rabbits-robotics/gamma_turret_pcb/docs/回路図作成リファレンス.md

# ESP32-P4キャリア 回路リファレンス（現状版）

2026-08-10全面改訂: **完成した回路図のネットリストから機械生成**した現状正引き文書。
初版（描き始め用ガイド。逆接保護・TVS・ESC保護抵抗・PWR_FLAG等の不採用部品を含む）はgit履歴を参照。
設計判断の経緯・理由は `2026-08-10-esp32-p4-carrier-design.md`。

## 1. U1（Stampソケット）ピン対応

| ピン# | Stamp信号 | 接続先 | | ピン# | Stamp信号 | 接続先 |
|---|---|---|---|---|---|---|
| 1 | G15 | IMU_RX ← U3.3(BNO055のT) | | 11 | G23 | CAN1_TX → U6.1（D4アクティビティLED付き） |
| 2 | G12 | IMU_TX → U3.4（R7 10kプルアップ） | | 12 | G21 | CAN1_RX ← U6.4 |
| 3 | G10 | SRV_RX（R1 1k経由で合流点へ） | | 13 | G19 | CAN2_TX → U5.1（D5 LED付き） |
| 4 | G8 | SRV_TX（R2 1k経由で合流点へ・D6 LED付き） | | 14 | G17 | CAN2_RX ← U5.4 |
| 5 | G1 | FIRE_LEFT_MOTOR → FireLeft1.1 | | 15 | 3V3出力 | +3V3レール |
| 6 | G0 | FIRE_RIGHT_MOTOR → FireRight1.1 | | 16 | G37⚠ | R17 10kプルアップ＋D2デバッグLED（吸い込み） |
| 7 | GND | GND | | 17 | G38⚠ | R18 10kプルアップ＋D3デバッグLED（吸い込み） |
| 8 | VBUS | +5V（M78AR05出力） | | 18 | EN | RESET_SW1 → GND |
| 9 | G27 | PC_RX ← R6(220) ← PC1.2 | | 19 | G35⚠ | BOOT_SW1 → GND |
| 10 | G26 | PC_TX → R5(220) → PC1.1（R4 10kプルアップはコネクタ側） | | 20 | GND | GND |

⚠=ブートストラップピン（G37/G38はLED・プルアップのみ＝出力系で安全運用、G35はボタン専用）

## 2. 部品一覧（回路図の実体・全46点）

| Ref | 値 | 役割 |
|---|---|---|
| 24Vin1 | Conn_01x02 | XT30オス 24V入力 |
| BOOT_SW1 | SW_Push | タクトSW 低背4.3mm（BOOT） |
| C1 | 100n | 100n U6パスコン |
| C2 | 100n | 100n U5パスコン |
| C3 | 100u | 100µ電解 +5V出力側 |
| C4 | 100u | 100µ電解 +24V入力 |
| C5 | 22u | 22µ積セラ +24V入力 |
| CAN1 | Conn_01x02 | PH2P CANH/L |
| CAN2 | Conn_01x02 | PH2P CANH/L |
| D1 | LED | LED緑 電源+5V |
| D2 | LED | LED黄 デバッグG37 |
| D3 | LED | LED黄緑 デバッグG38 |
| D4 | LED | LED赤 CAN1アクティビティ |
| D5 | LED | LED赤 CAN2アクティビティ |
| D6 | LED | LED橙 サーボアクティビティ |
| DCDCin | Conn_01x02 | XT30オス 7.4V入力（外部DCDCから） |
| DCDCout | Conn_01x02 | XT30メス 24V出力（外部DCDCへ） |
| FireLeft1 | Conn_01x02 | PH2P ESC信号左 |
| FirePower1 | Conn_01x02 | XH2P 7.5V分配 |
| FirePower2 | Conn_01x02 | XH2P 7.5V分配 |
| FireRight1 | Conn_01x02 | PH2P ESC信号右 |
| PC1 | Conn_01x03 | PH3P Jetson UART |
| R1 | 1k | 1k サーボ合流RX側 |
| R10 | 1k | 1k LED D2 |
| R11 | 1k | 1k LED D3 |
| R12 | 1k | 1k LED D4 |
| R13 | 1k | 1k LED D5 |
| R14 | 1k | 1k LED D6 |
| R17 | 10k | 10k G37プルアップ |
| R18 | 10k | 10k G38プルアップ |
| R19 | 120 | 120 CAN1終端 |
| R2 | 1k | 1k サーボ合流TX側 |
| R3 | 10k | 10k サーボバスプルアップ |
| R4 | 10k | 10k Jetson TXプルアップ |
| R5 | 220 | 220 Jetson TX直列 |
| R6 | 220 | 220 Jetson RX直列 |
| R7 | 10k | 10k IMU_TXプルアップ |
| R8 | 1k | 1k 電源LED |
| R9 | 120 | 120 CAN2終端 |
| RESET_SW1 | SW_Push | タクトSW 7mm（RESET） |
| SRV1 | Conn_01x03 | XH3P ST3215バス |
| U1 | M5Stack_Stamp-P4 | Stamp-P4ソケット |
| U2 | M78AR05-1 | M78AR05-1 24V→5V |
| U3 | ~ | AE-BNO055-BO 直載せ |
| U5 | MCP2562-E-P | MCP2562FD CAN2 |
| U6 | MCP2562-E-P | MCP2562FD CAN1 |

## 3. 結線一覧（ネット別・ネットリストから自動生成）

| ネット | 接続 |
|---|---|
| GND | 24Vin1.1 BOOT_SW1.2 C1.2 C2.2 C3.2 C4.2 C5.2 D1.1 DCDCin.1 DCDCout.1 FireLeft1.2 FirePower1.2 FirePower2.2 FireRight1.2 PC1.3 RESET_SW1.2 SRV1.3 U1.20 U1.7 U2.2 U3.2 U3.7 U5.2 U5.8 U6.2 U6.8 |
| +3V3 | R10.1 R11.1 R12.1 R13.1 R14.1 R17.1 R18.1 R3.1 R4.1 R7.1 U1.15 U3.1 U5.5 U6.5 |
| +5V | C1.1 C2.1 C3.1 R8.1 U1.8 U2.3 U5.3 U6.3 |
| +24V | 24Vin1.2 C4.1 C5.1 DCDCout.2 U2.1 |
| +7.5V | DCDCin.2 FirePower1.1 FirePower2.1 SRV1.1 |
| （無名: SRV1-Pin_2） | R1.2 R2.1 R3.2 SRV1.2 |
| CAN1_TX | D4.1 U1.11 U6.1 |
| CAN2_TX | D5.1 U1.13 U5.1 |
| IMU_TX | R7.2 U1.2 U3.4 |
| SRV_TX | D6.1 R2.2 U1.4 |
| （無名: CAN1-Pin_1） | CAN1.1 R19.1 U6.7 |
| （無名: CAN1-Pin_2） | CAN1.2 R19.2 U6.6 |
| （無名: CAN2-Pin_1） | CAN2.1 R9.1 U5.7 |
| （無名: CAN2-Pin_2） | CAN2.2 R9.2 U5.6 |
| （無名: D2-K） | D2.1 R17.2 U1.16 |
| （無名: D3-K） | D3.1 R18.2 U1.17 |
| （無名: PC1-Pin_1） | PC1.1 R4.2 R5.2 |
| CAN1_RX | U1.12 U6.4 |
| CAN2_RX | U1.14 U5.4 |
| FIRE_LEFT_MOTOR | FireLeft1.1 U1.5 |
| FIRE_RIGHT_MOTOR | FireRight1.1 U1.6 |
| IMU_RX | U1.1 U3.3 |
| PC_RX | R6.1 U1.9 |
| PC_TX | R5.1 U1.10 |
| SRV_RX | R1.1 U1.3 |
| （無名: D1-A） | D1.2 R8.2 |
| （無名: D2-A） | D2.2 R10.2 |
| （無名: D3-A） | D3.2 R11.2 |
| （無名: D4-A） | D4.2 R12.2 |
| （無名: D5-A） | D5.2 R13.2 |
| （無名: D6-A） | D6.2 R14.2 |
| （無名: PC1-Pin_2） | PC1.2 R6.2 |
| （無名: U1-EN） | RESET_SW1.1 U1.18 |
| （無名: U1-G35_BOOT） | BOOT_SW1.1 U1.19 |

## 4. 検証の現状ルール

- 結線照合: `python check_nets.py` → `OK: all nets match` が正常（expected_nets.csvが正解表）
- ERC: **エラー3件（+24V・GND・+7.5Vの電源未駆動）は許容ベースライン**（PWR_FLAG非採用の設計判断による）。これ以外のエラー・警告が出たら要調査
- 未対応事項: アノテーション警告（実害なし・自作シンボルのReference設定が有力容疑）

## 5. フットプリント・実部品 完全対応表（2026-08-10確定）

KiCadの「フットプリント割り当てツール」でこの表の通りに割当。**ピン↔パッド対応は全数機械検証済み**。

| Ref | 実部品（購入品） | フットプリント |
|---|---|---|
| U1 | [M5Stack Stamp-P4](https://shop.m5stack.com/products/m5stamp-esp32p4-module) 本体＋**[分割ロングピンソケット1×42 FHU-1x42SG（秋月105779・¥80）](https://akizukidenshi.com/catalog/g/g105779/)を10Pずつ切って2本**（基板に載るのはソケットの方） | `User:Stamp-P4_Socket_2x10_P2.54mm_RS20.32mm`（自作・検証済み。ピン1=左上・下端USB-C表記） |
| U2 | [M78AR05-1（秋月113536・¥850）](https://akizukidenshi.com/catalog/g/g113536/) | `Converter_DCDC:Converter_DCDC_RECOM_R-78E-0.5_THT`（ピン互換。**本体がR-78Eよりひと回り大→レイアウトで余白**） |
| U3 | [AE-BNO055-BO（秋月116996）](https://akizukidenshi.com/catalog/g/g116996/)・**付属の細ピンヘッダで直はんだ前提** | `User:BNO055`（既存自作・ドリル0.76mm=細ピンヘッダ径。**⚠️丸ピンICソケット化するならドリル1.0mmに拡大改版が必要。直はんだなら現状のままでOK**） |
| U5, U6 | [MCP2562FD-E/P（秋月114383・¥200）](https://akizukidenshi.com/catalog/g/g114383/)×2・DIP8直はんだ | `Package_DIP:DIP-8_W7.62mm` |
| 24Vin1, DCDCin1 | [XT30PW-M（秋月117949・¥70）](https://akizukidenshi.com/catalog/g/g117949/)×2 **横出し**（基板取付用L型・2026-08-10全コネクタ横出し化） | `Connector_AMASS:AMASS_XT30PW-M_1x02_P2.50mm_Horizontal` |
| DCDCout1 | [XT30PW-F（秋月117948・¥70）](https://akizukidenshi.com/catalog/g/g117948/) **横出しメス**（24Vを外部DCDCへ送る出口。電源供給側=メスの作法） | `Connector_AMASS:AMASS_XT30PW-F_1x02_P2.50mm_Horizontal` |
| CAN1, CAN2, FireLeft1, FireRight1 | [JST S2B-PH-K-S（秋月112633・¥10）](https://akizukidenshi.com/catalog/g/g112633/)×4（PH横 2P） | `Connector_JST:JST_PH_S2B-PH-K_1x02_P2.00mm_Horizontal` |
| FirePower1, FirePower2 | [JST S2B-XH-A（秋月112262・¥15）](https://akizukidenshi.com/catalog/g/g112262/)×2（XH横 2P） | `Connector_JST:JST_XH_S2B-XH-A_1x02_P2.50mm_Horizontal` |
| SRV1, PC1 | [JST S3B-XH-A（秋月112263・¥15）](https://akizukidenshi.com/catalog/g/g112263/)×2（XH横 3P。**PC1は2026-08-10にPH→XHへ変更** — PH横3Pが秋月非取扱のため。SRV1と材料共通化） | `Connector_JST:JST_XH_S3B-XH-A_1x03_P2.50mm_Horizontal` |
| BOOT_SW1 | 6mm角タクトSW **高さ4.3mm低背**（[秋月のタクトSW検索](https://akizukidenshi.com/catalog/goods/search.aspx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)から選定） | `Button_Switch_THT:SW_PUSH_6mm` |
| RESET_SW1 | 6mm角タクトSW **高さ7mm級**（同上） | `Button_Switch_THT:SW_PUSH_6mm`（BOOT_SWと共通、高さは部品側の違い） |
| R1〜R19の各抵抗 | [カーボン1/4W小型 CF25Jシリーズ 100本袋・例: 1kΩ（125102・¥100）](https://akizukidenshi.com/catalog/g/g125102/)。**1k×8・10k×5・220Ω×2・120Ω×2** — 他の値は「カーボン抵抗 10kΩ」等で同シリーズを検索 | `Resistor_THT:R_Axial_DIN0204_L3.6mm_D1.6mm_P5.08mm_Horizontal`（秋月現行1/4Wは小型品のためDIN0204/P5.08） |
| C1, C2 | [積層セラ0.1µF50V X7R 2.54mmピッチ 10個入（113582・¥100）](https://akizukidenshi.com/catalog/g/g113582/) | `Capacitor_THT:C_Disc_D5.0mm_W2.5mm_P2.50mm` |
| C3 | [電解100µF/35V 105℃ ルビコンZLH（102724・¥15）](https://akizukidenshi.com/catalog/g/g102724/)（C4と同一部品・**2026-08-10統一確定**。M78AR05出力上限470µFに対し余裕3倍で仕様内） | `Capacitor_THT:CP_Radial_D6.3mm_P2.50mm`（C4と同じ。C_Polarized・+側=+5Vで極性検証済み） |
| C4 | [電解100µF/35V 105℃ ルビコンZLH（102724・¥15）](https://akizukidenshi.com/catalog/g/g102724/)（φ6.3×11/ピッチ2.5） | `Capacitor_THT:CP_Radial_D6.3mm_P2.50mm`（シンボルはC_Polarized・+側=+24Vで極性検証済み） |
| C5 | [積層セラ22µF50V X7S **5mmピッチ**（108156・¥80）](https://akizukidenshi.com/catalog/g/g108156/) | `Capacitor_THT:C_Disc_D7.5mm_W5.0mm_P5.00mm`（**部品ピッチ5mmのためP2.50→P5.00に修正**） |
| D1 | [緑 OSG5TA3Z74A（111635）](https://akizukidenshi.com/catalog/g/g111635/)・電源 | `LED_THT:LED_D3.0mm`（1=K/2=A、シンボルと一致） |
| D2 | [黄 OSY5JA3Z74A（111639）](https://akizukidenshi.com/catalog/g/g111639/)・デバッグG37 | 同上 |
| D3 | [黄緑 OSG8HA3Z74A（111637）](https://akizukidenshi.com/catalog/g/g111637/)・デバッグG38 | 同上 |
| D4, D5 | [赤 OSR5JA3Z74A（111577）](https://akizukidenshi.com/catalog/g/g111577/)×2・CANアクティビティ | 同上 |
| D6 | [橙 低消費 OSO5PA3133A-1MA（116909）](https://akizukidenshi.com/catalog/g/g116909/)・サーボアクティビティ | 同上 |

割当後の検証: `python check_nets.py`は割当の有無に関係なく通る。フットプリント漏れは回路図エディタのERCかpcbnew更新時のエラーで検出。

## 6. 参照

- 設計判断の経緯・BOM・ファーム申し送り → `2026-08-10-esp32-p4-carrier-design.md`
- 初版の描き方ガイド（不採用部品を含む） → git履歴のこのファイル旧版
- Stampソケットフットプリント根拠 → M5Stack公式寸法図PDF（穴グリッド2×10・列間20.32mm実測）
