rabbits-robotics/gamma_turret_pcb/bom.csv

Reference | Value | Footprint | QUANTITY
24Vin1,DCDCin1 | Conn_01x02 | Connector_AMASS:AMASS_XT30PW-M_1x02_P2.50mm_Horizontal | 2
BOOT_SW1,RESET_SW1 | SW_Push | Button_Switch_THT:SW_PUSH_6mm | 2
C1,C2 | 100n | Capacitor_THT:C_Disc_D5.0mm_W2.5mm_P2.50mm | 2
C3,C4 | 100u | Capacitor_THT:CP_Radial_D6.3mm_P2.50mm | 2
C5 | 22u | Capacitor_THT:C_Disc_D7.5mm_W5.0mm_P5.00mm | 1
CAN1,CAN2,FireLeft1,FireRight1 | Conn_01x02 | Connector_JST:JST_PH_S2B-PH-K_1x02_P2.00mm_Horizontal | 4
D1-D6 | LED | LED_THT:LED_D3.0mm | 6
DCDCout1 | Conn_01x02 | Connector_AMASS:AMASS_XT30PW-F_1x02_P2.50mm_Horizontal | 1
FirePower1,FirePower2 | Conn_01x02 | Connector_JST:JST_XH_S2B-XH-A_1x02_P2.50mm_Horizontal | 2
PC1,SRV1 | Conn_01x03 | Connector_JST:JST_XH_S3B-XH-A_1x03_P2.50mm_Horizontal | 2
R1,R2,R8,R10-R14 | 1k | Resistor_THT:R_Axial_DIN0204_L3.6mm_D1.6mm_P5.08mm_Horizontal | 8
R3,R4,R7,R17,R18 | 10k | Resistor_THT:R_Axial_DIN0204_L3.6mm_D1.6mm_P5.08mm_Horizontal | 5
R5,R6 | 220 | Resistor_THT:R_Axial_DIN0204_L3.6mm_D1.6mm_P5.08mm_Horizontal | 2
R9,R19 | 120 | Resistor_THT:R_Axial_DIN0204_L3.6mm_D1.6mm_P5.08mm_Horizontal | 2
U1 | M5Stack_Stamp-P4 | User:Stamp-P4_Socket_2x10_P2.54mm_RS20.32mm | 1
U2 | M78AR05-1 | Converter_DCDC:Converter_DCDC_RECOM_R-78E-0.5_THT | 1
U3 | ~ | User:BNO055 | 1
U5,U6 | MCP2562-E-P | Package_DIP:DIP-8_W7.62mm | 2
