rabbits-robotics/gamma_turret_pcb/gamma_turret.step

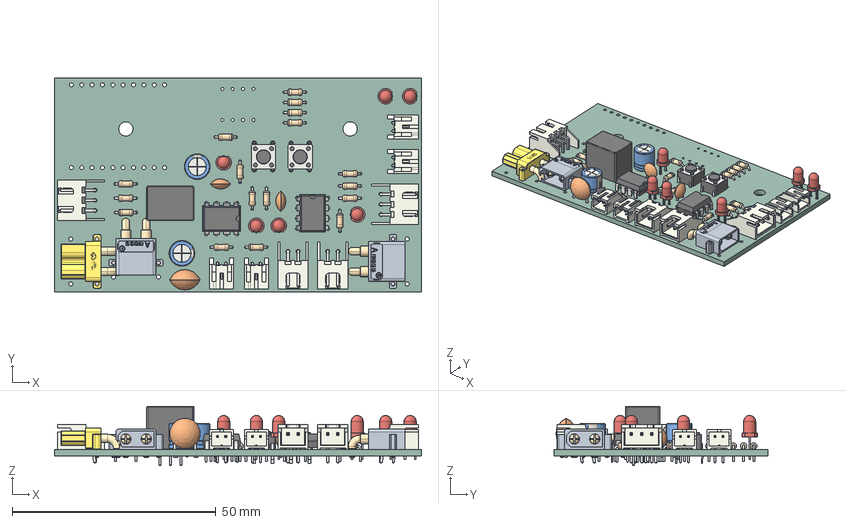
[picture p1: CAD file, 2026-10-18]
gamma_turret.step
90.0 x 52.5 x 14.5 mm
CONN-TH_XT30PW-M x 2
R_Axial_DIN0204_L36mm_D16mm_P508mm_Horizontal x 17
LED_D3.0mm x 6
C_Disc_D50mm_W25mm_P250mm x 2
JST_S2B_XH_A x 2
Converter_DCDC_RECOM_R_78E_05_THT
JST_S3B_XH_A x 2
JST_S2B_PH_K x 4
SW_PUSH_6mm x 2
DIP-8_W7.62mm x 2
CP_Radial_D63mm_P250mm x 2
C_Disc_D75mm_W50mm_P500mm
CONN-TH_XT30PW-F-1
gamma_turret_PCB
