rabbits-robotics/gamma_turret_pcb/gamma_turret.pdf

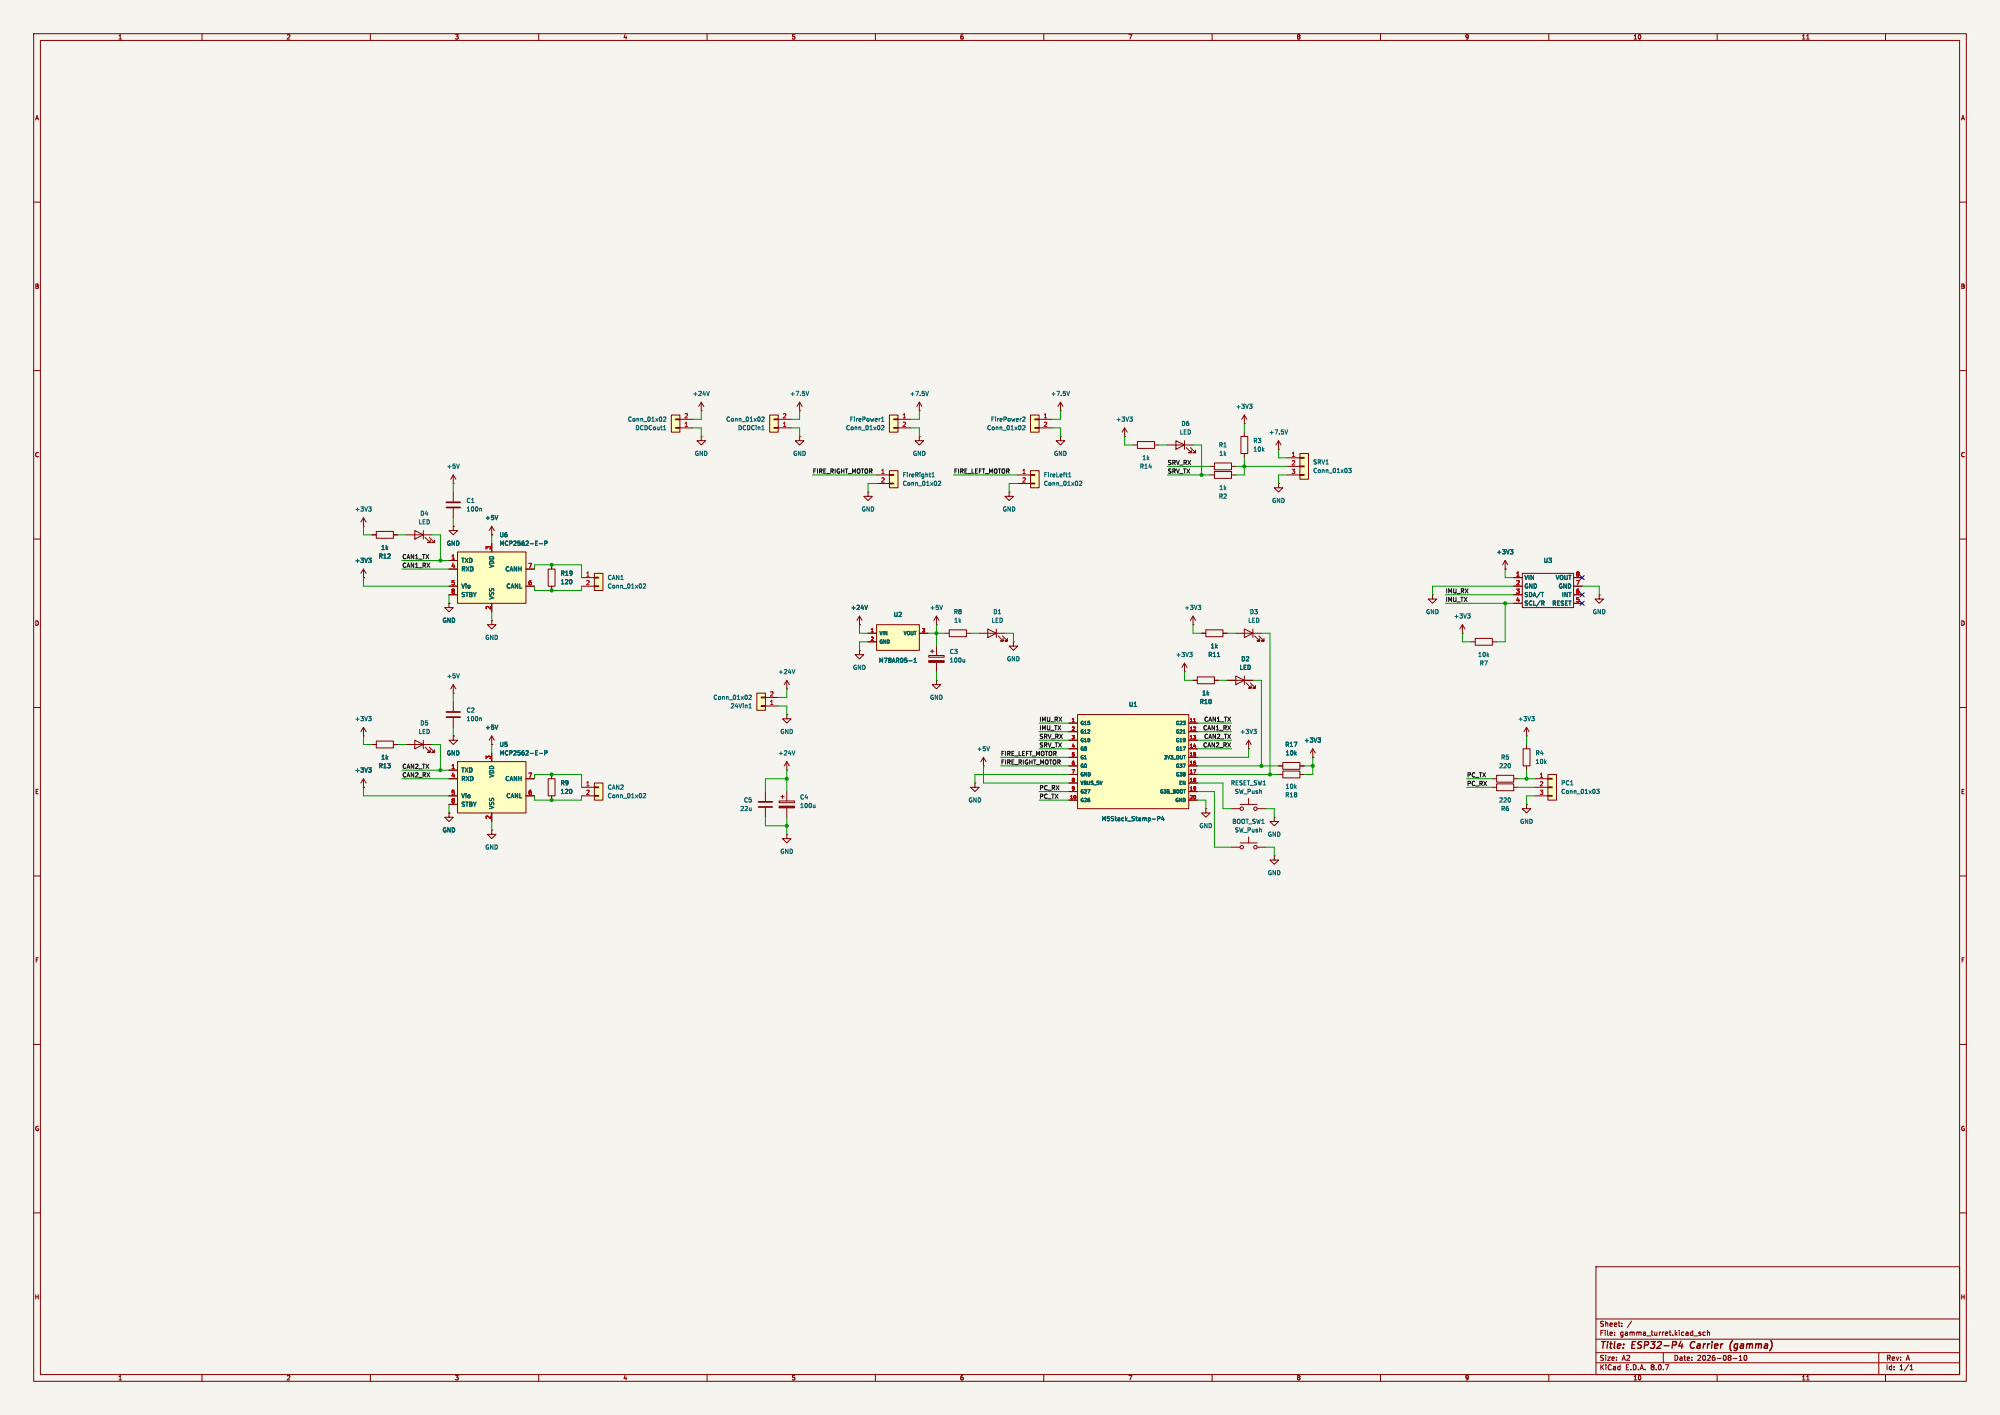
[picture p2: page 1]

3 RXD 4 Vio 5 CANL 6 CANH 7 STBY 8 U6 MCP2562-E-P D3

3 RXD 4 Vio 5 CANL 6 CANH 7 STBY 8 R19

3 RXD 4 Vio 5 CANL 6 CANH 7 STBY 8 U5 MCP2562-E-P R6

3 RXD 4 Vio 5 CANL 6 CANH 7 STBY 8 +3V3 R13
