rabbits-robotics/gamma_turret_pcb/gamma_turret.kicad_pcb

## KiCad design gamma_turret.kicad_pcb (2026-10-18)

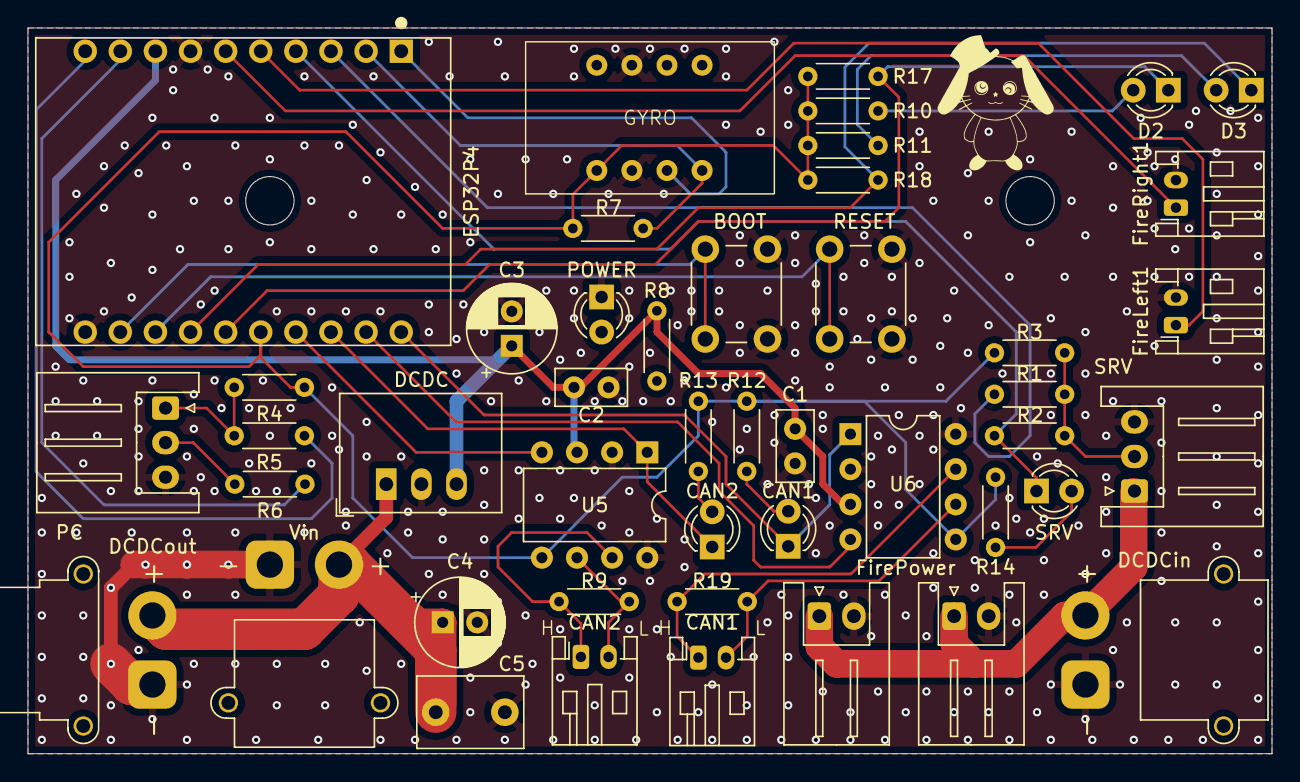
[picture p3: board gamma_turret.kicad_pcb from above]

Board: 2 copper layers, 90.0 x 52.5 mm, 46 parts (0 on the bottom side), 34 nets.

Parts:
BOOT: SW_Push; SW_PUSH_6mm
C1, C2: 100n; C_Disc_D5.0mm_W2.5mm_P2.50mm
C3, C4: 100u; CP_Radial_D6.3mm_P2.50mm
C5: 22u; C_Disc_D7.5mm_W5.0mm_P5.00mm
CAN1, CAN2#2: LED; LED_D3.0mm
CAN1#2, CAN2: Conn_01x02; JST_PH_S2B-PH-K_1x02_P2.00mm_Horizontal
D2, D3: LED; LED_D3.0mm
DCDC: M78AR05-1; Converter_DCDC_RECOM_R-78E-0.5_THT
DCDCin: Conn_01x02; AMASS_XT30PW-M_1x02_P2.50mm_Horizontal
DCDCout: Conn_01x02; AMASS_XT30PW-F_1x02_P2.50mm_Horizontal
ESP32P4: M5Stack_Stamp-P4; Stamp-P4_Socket_2x10_P2.54mm_RS20.32mm
FireLeft1: Conn_01x02; JST_PH_S2B-PH-K_1x02_P2.00mm_Horizontal
FirePower, FirePower2: Conn_01x02; JST_XH_S2B-XH-A_1x02_P2.50mm_Horizontal
FireRight1: Conn_01x02; JST_PH_S2B-PH-K_1x02_P2.00mm_Horizontal
GYRO: BNO055
PC: Conn_01x03; JST_XH_S3B-XH-A_1x03_P2.50mm_Horizontal
POWER: LED; LED_D3.0mm
R1, R2, R8, R10, R11, R12, R13, R14: 1k; R_Axial_DIN0204_L3.6mm_D1.6mm_P5.08mm_Horizontal
R3, R4, R7, R17, R18: 10k; R_Axial_DIN0204_L3.6mm_D1.6mm_P5.08mm_Horizontal
R5, R6: 220; R_Axial_DIN0204_L3.6mm_D1.6mm_P5.08mm_Horizontal
R9, R19: 120; R_Axial_DIN0204_L3.6mm_D1.6mm_P5.08mm_Horizontal
RESET: SW_Push; SW_PUSH_6mm
SRV: LED; LED_D3.0mm
SRV#2: Conn_01x03; JST_XH_S3B-XH-A_1x03_P2.50mm_Horizontal
U5, U6: MCP2562-E-P; DIP-8_W7.62mm
Vin: Conn_01x02; AMASS_XT30PW-M_1x02_P2.50mm_Horizontal

Connections:
+3V3: ESP32P4.15 (3V3_OUT), GYRO.1 (VIN), R3.1, R4.1, R7.1, R10.1, R11.1, R12.1, R13.1, R14.1, R17.1, R18.1, U5.5 (Vio), U6.5 (Vio)
+5V: C1.1, C2.1, C3.1, DCDC.3 (VOUT), ESP32P4.8 (VBUS_5V), R8.1, U5.3 (VDD), U6.3 (VDD)
+7.5V: DCDCin.2, FirePower.1, FirePower2.1, SRV#2.1
+24V: C4.1, C5.1, DCDC.1 (VIN), DCDCout.2, Vin.2
/CAN1_RX: ESP32P4.12 (G21), U6.4 (RXD)
/CAN1_TX: CAN1.1 (K), ESP32P4.11 (G23), U6.1 (TXD)
/CAN2_RX: ESP32P4.14 (G17), U5.4 (RXD)
/CAN2_TX: CAN2#2.1 (K), ESP32P4.13 (G19), U5.1 (TXD)
/FIRE_LEFT_MOTOR: ESP32P4.5 (G1), FireLeft1.1
/FIRE_RIGHT_MOTOR: ESP32P4.6 (G0), FireRight1.1
/IMU_RX: ESP32P4.1 (G15), GYRO.3 (SDA/T)
/IMU_TX: ESP32P4.2 (G12), GYRO.4 (SCL/R), R7.2
/PC_RX: ESP32P4.9 (G27), R6.1
/PC_TX: ESP32P4.10 (G26), R5.1
/SRV_RX: ESP32P4.3 (G10), R1.1
/SRV_TX: ESP32P4.4 (G8), R2.2, SRV.1 (K)
GND: BOOT.2, C1.2, C2.2, C3.2, C4.2, C5.2, DCDC.2 (GND), DCDCin.1, DCDCout.1, ESP32P4.7 (GND), ESP32P4.20 (GND), FireLeft1.2, FirePower.2, FirePower2.2, FireRight1.2, GYRO.2 (GND), GYRO.7 (GND), PC.3, POWER.1 (K), RESET.2, SRV#2.3, U5.2 (VSS), U5.8 (STBY), U6.2 (VSS), U6.8 (STBY), Vin.1
unnamed: CAN1#2.1, R19.1, U6.7 (CANH)
unnamed: CAN1#2.2, R19.2, U6.6 (CANL)
unnamed: CAN2.1, R9.1, U5.7 (CANH)
unnamed: CAN2.2, R9.2, U5.6 (CANL)
unnamed: POWER.2 (A), R8.2
unnamed: D2.2 (A), R10.2
unnamed: D2.1 (K), ESP32P4.16 (G37), R17.2
unnamed: D3.2 (A), R11.2
unnamed: D3.1 (K), ESP32P4.17 (G38), R18.2
unnamed: CAN1.2 (A), R12.2
unnamed: CAN2#2.2 (A), R13.2
unnamed: R14.2, SRV.2 (A)
unnamed: PC.1, R4.2, R5.2
unnamed: PC.2, R6.2
unnamed: R1.2, R2.1, R3.2, SRV#2.2
unnamed: ESP32P4.18 (EN), RESET.1
unnamed: BOOT.1, ESP32P4.19 (G35_BOOT)
