rabbits-robotics/gamma_turret_pcb/old_design/gamma_turret.kicad_pcb

## KiCad design old_design/gamma_turret.kicad_pcb (2026-10-18, an earlier design)

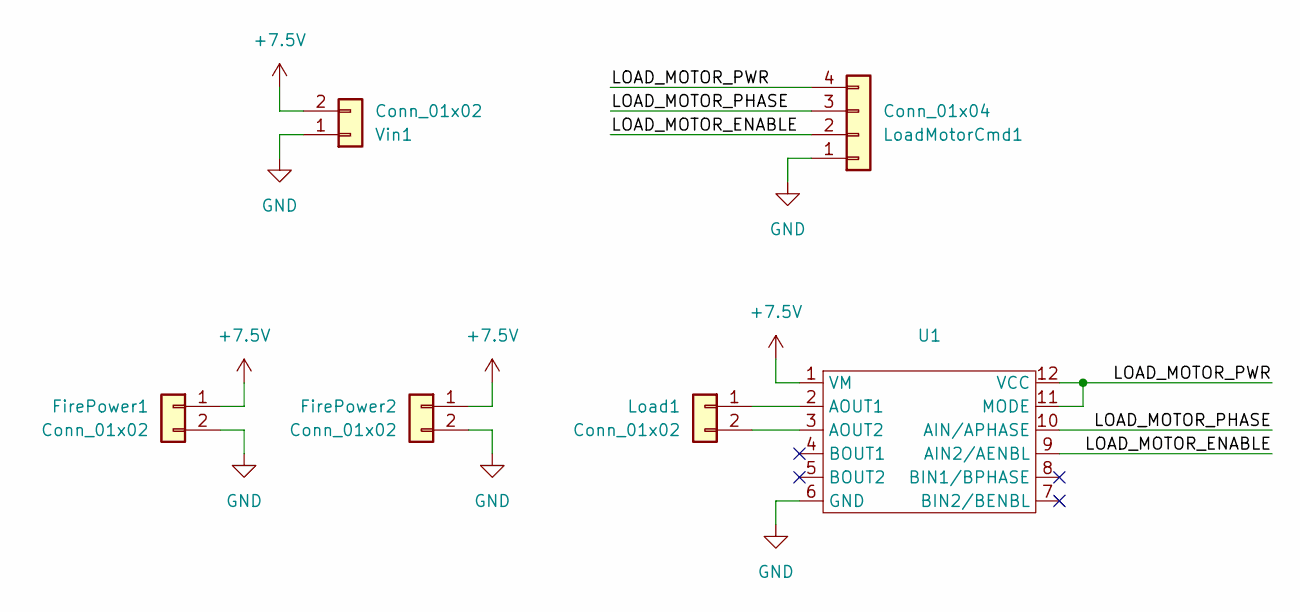
[picture p4: schematic gamma_turret.kicad_sch]

Parts:
FirePower1, FirePower2: Conn_01x02; JST_XH_B2B-XH-A_1x02_P2.50mm_Vertical
Load1: Conn_01x02; JST_PH_B2B-PH-K_1x02_P2.00mm_Vertical
LoadMotorCmd1: Conn_01x04; JST_PH_B4B-PH-K_1x04_P2.00mm_Vertical
U1: DRV8835
Vin1: Conn_01x02; TerminalBlock_bornier-2_P5.08mm

Connections:
+7.5V: FirePower1.1, FirePower2.1, U1.1 (VM), Vin1.2
/LOAD_MOTOR_ENABLE: LoadMotorCmd1.2, U1.9 (AIN2/AENBL)
/LOAD_MOTOR_PHASE: LoadMotorCmd1.3, U1.10 (AIN/APHASE)
/LOAD_MOTOR_PWR: LoadMotorCmd1.4, U1.11 (MODE), U1.12 (VCC)
GND: FirePower1.2, FirePower2.2, LoadMotorCmd1.1, U1.6 (GND), Vin1.1
unnamed: Load1.1, U1.2 (AOUT1)
unnamed: Load1.2, U1.3 (AOUT2)

Board: 2 copper layers, 6 parts (0 on the bottom side), 7 nets, no tracks yet.
