rabbits-robotics/gamma_turret_pcb/(commit log)

2026-10-18 KiCad プロジェクトを追加（2026-08-12 発注版）
    [bom.csv, gamma_turret.kicad_pcb, gamma_turret.kicad_sch, gamma_turret.step]
2026-10-18 v1.0 の火入れ結果とジャンパ対応を記録
2026-10-22 USB からの 5V 逆流を記録
2026-10-22 BNO055 モジュールの実装結果とジャンパ設定を記録
2026-10-31 BNO055 モジュールの J3 / J5 同時接続による短絡を記録する
